dcorbeil/mysterium/mysterium_BOM.xlsx

Qty | Line Item | Manufacturer | MPN | Octopart URL | Schematic Reference | Internal Part Number | Description | Total Qty (@ Batch Size: 1) | SKU | Packaging | Unit Price (@ Batch Size: 1) | In Stock | MOQ | URL | Distributor [Lowest Price (Overall)] | SKU [Lowest Price (Overall)] | Packaging [Lowest Price (Overall)] | Unit Price (@ Batch Size: 1) [Lowest Price (Overall)] | Line Total [Lowest Price (Overall)] | Batch Total [Lowest Price (Overall)] | In Stock [Lowest Price (Overall)] | MOQ [Lowest Price (Overall)] | URL [Lowest Price (Overall)] | Notes
 |  |  |  |  |  |  |  |  | Mouser | Mouser | Mouser | Mouser | Mouser | Mouser
1 | ATMEGA32A-PU | Microchip | ATMEGA32A-PU | https://octopart.com/atmega32a-pu-microchip-77760288 |  |  | atmega32a-pu | 1 | 556-ATMEGA32A-PU | Tube | 3.88 | 215 | 1 | https://octopart.com/click/track?ai=8237&sig=0e0eec9&sid=2401&ppid=77760288&vpid=408978644&ct=offers | iodParts | ATMEGA32A-PU |  | 2.212 | 2.212 | 2.212 | 20 | 1 | https://octopart.com/click/track?ai=8237&sig=0d57c2a&sid=26822&ppid=77760288&vpid=418564695&ct=offers
1 | 1-2199299-5 | TE Connectivity | 1-2199299-5 | https://octopart.com/1-2199299-5-te+connectivity-34963610 |  |  | 40 pin ic socket | 1 | 571-1-2199299-5 | Tube | 0.79 | 10319 | 1 | https://octopart.com/click/track?ai=8237&sig=0bd913c&sid=2401&ppid=34963610&vpid=165549125&ct=offers | Future Electronics | 5048916 | Tube | 0.495 | 0.495 | 0.495 | 679 | 1 | https://octopart.com/click/track?ai=8237&sig=06217de&sid=2454&ppid=34963610&vpid=416925582&ct=offers
87 | 512-1N4148TR | ON Semiconductor | 1N4148TR | https://octopart.com/1n4148tr-on+semiconductor-84323125 |  |  | 1n4148 diode | 87 | 512-1N4148TR | Tape & Reel | 0.055 | 894714 | 1 | https://octopart.com/click/track?ai=8237&sig=010fed8&sid=2401&ppid=84323125&vpid=438579221&ct=offers | Freelance Electronics | 1N4148TR |  | 0.0045 | 0.3915 | 0.3915 | 15364 | 1 | https://octopart.com/click/track?ai=8237&sig=02951a1&sid=13062&ppid=84323125&vpid=44157962&ct=offers
2 | TZX3V6A-TR | Vishay | TZX3V6A-TR | https://octopart.com/tzx3v6a-tr-vishay-41954837 |  |  | zener diode (3.6v) | 2 | 78-TZX3V6A | Tape & Reel | 0.19 | 27260 | 1 | https://octopart.com/click/track?ai=8237&sig=07bdbc1&sid=2401&ppid=41954837&vpid=165620622&ct=offers | Arrow Electronics | TZX3V6A-TR | Cut Tape | 0.0741 | 0.1482 | 0.1482 | 28796 | 1 | https://octopart.com/click/track?ai=8237&sig=03dec76&sid=1106&ppid=41954837&vpid=473542905&ct=offers
1 | MF-R050 | Bourns | MF-R050 | https://octopart.com/mf-r050-bourns-19418 |  |  | 500mA fuse | 1 | 652-MFR050 | Bulk | 0.37 | 7313 | 1 | https://octopart.com/click/track?ai=8237&sig=00f51fc&sid=2401&ppid=19418&vpid=37642983&ct=offers | Newark | 58K1838 |  | 0.293 | 0.293 | 0.293 | 4792 | 1 | https://octopart.com/click/track?ai=8237&sig=0504032&sid=2402&ppid=19418&vpid=2999775&ct=offers
2 | 603-CFR-12JR-52-75R | Yageo | CFR-12JR-52-75R | https://octopart.com/cfr-12jr-52-75r-yageo-22569004 |  |  | 75 ohm resistor (1/6w) | 2 | 603-CFR-12JR-52-75R | Tape & Reel | 0.1 | 2943 | 1 | https://octopart.com/click/track?ai=8237&sig=0306453&sid=2401&ppid=22569004&vpid=459007506&ct=offers | Mouser | 603-CFR-12JR-52-75R | Tape & Reel | 0.1 | 0.2 | 0.2 | 2943 | 1 | https://octopart.com/click/track?ai=8237&sig=0306453&sid=2401&ppid=22569004&vpid=459007506&ct=offers
2 | MFR-12FTF52-1K5 | Yageo | MFR-12FTF52-1K5 | https://octopart.com/mfr-12ftf52-1k5-yageo-70521551 |  |  | 1.5k resistor (1/6w) | 2 | 603-MFR-12FTF52-1K5 | Ammo Pack | 0.14 | 7317 | 1 | https://octopart.com/click/track?ai=8237&sig=05e16d3&sid=2401&ppid=70521551&vpid=248138223&ct=offers | Mouser | 603-MFR-12FTF52-1K5 | Ammo Pack | 0.14 | 0.28 | 0.28 | 7317 | 1 | https://octopart.com/click/track?ai=8237&sig=05e16d3&sid=2401&ppid=70521551&vpid=248138223&ct=offers
2 | MFR-12FTF52-5K1 | Yageo | MFR-12FTF52-5K1 | https://octopart.com/mfr-12ftf52-5k1-yageo-27599083 |  |  | 5.1k resistor (1/6w) | 2 | 603-MFR-12FTF52-5K1 | Ammo Pack | 0.14 | 2811 | 1 | https://octopart.com/click/track?ai=8237&sig=035d3f5&sid=2401&ppid=27599083&vpid=69905114&ct=offers | Mouser | 603-MFR-12FTF52-5K1 | Ammo Pack | 0.14 | 0.28 | 0.28 | 2811 | 1 | https://octopart.com/click/track?ai=8237&sig=035d3f5&sid=2401&ppid=27599083&vpid=69905114&ct=offers
1 | MFR-12FTF52-10K | Yageo | MFR-12FTF52-10K | https://octopart.com/mfr-12ftf52-10k-yageo-27599081 |  |  | 10k resistor (1/6w) | 1 | 603-MFR-12FTF52-10K | Ammo Pack | 0.14 | 0 | 1 | https://octopart.com/click/track?c=1&ai=8237&sig=06c5f3c&sid=2401&ppid=27599081&vpid=69905112&ct=offers | Arrow.cn | MFR12FTF5210K#YAGEO |  | 0.0594 | 0.0594 | 0.0594 | 2360 | 1 | https://octopart.com/click/track?ai=8237&sig=0be1695&sid=28928&ppid=27599081&vpid=617478633&ct=offers
1 | UMT1H4R7MDD | Nichicon | UMT1H4R7MDD | https://octopart.com/umt1h4r7mdd-nichicon-19784074 |  |  | 4.7uF capacitor | 1 | 647-UMT1H4R7MDD | Bulk | 0.21 | 0 | 1 | https://octopart.com/click/track?c=1&ai=8237&sig=044daa9&sid=2401&ppid=19784074&vpid=456325084&ct=offers | Mouser | 647-UMT1H4R7MDD | Bulk | 0.21 | 0.21 | 0.21 | 0 | 1 | https://octopart.com/click/track?c=1&ai=8237&sig=044daa9&sid=2401&ppid=19784074&vpid=456325084&ct=offers
2 | RDER71H104K0M1H03A | Murata | RDER71H104K0M1H03A | https://octopart.com/rder71h104k0m1h03a-murata-38816908 |  |  | 0.1uF capacitor | 2 | 81-RDER71H104K0M1H3A | Ammo Pack | 0.31 | 58783 | 1 | https://octopart.com/click/track?ai=8237&sig=0178a58&sid=2401&ppid=38816908&vpid=193794682&ct=offers | Arrow Electronics | RDER71H104K0M1H03A | Cut Tape | 0.2832 | 0.5664 | 0.5664 | 51 | 1 | https://octopart.com/click/track?ai=8237&sig=051aa36&sid=1106&ppid=38816908&vpid=473338386&ct=offers
2 | RCE5C2A220J0A2H03B | Murata | RCE5C2A220J0A2H03B | https://octopart.com/rce5c2a220j0a2h03b-murata-30233632 |  |  | 22pF capacitor | 2 | 81-RCE5C2A220J0A2H3B | Bulk | 0.48 | 2392 | 1 | https://octopart.com/click/track?ai=8237&sig=0b9f246&sid=2401&ppid=30233632&vpid=89300106&ct=offers | Mouser | 81-RCE5C2A220J0A2H3B | Bulk | 0.48 | 0.96 | 0.96 | 2392 | 1 | https://octopart.com/click/track?ai=8237&sig=0b9f246&sid=2401&ppid=30233632&vpid=89300106&ct=offers
1 | ABL-16.000MHz-B4Y | Abracon | ABL-16.000MHZ-B4Y | https://octopart.com/abl-16.000mhz-b4y-abracon-75296064 |  |  | 16mhz crystal | 1 | 815-ABL-16-B4Y | Bulk | 0.34 | 718 | 1 | https://octopart.com/click/track?ai=8237&sig=02adf4a&sid=2401&ppid=75296064&vpid=269061007&ct=offers | Mouser | 815-ABL-16-B4Y | Bulk | 0.34 | 0.34 | 0.34 | 718 | 1 | https://octopart.com/click/track?ai=8237&sig=02adf4a&sid=2401&ppid=75296064&vpid=269061007&ct=offers
2 | MJTP1230A | APEM | MJTP1230A | https://octopart.com/mjtp1230a-apem-912864 |  |  | 6mm pushbutton | 2 | 642-MJTP1230A | Bulk | 0.2 | 4431 | 1 | https://octopart.com/click/track?ai=8237&sig=0b34d1b&sid=2401&ppid=912864&vpid=37704731&ct=offers | Heilind Electronics | MJTP1230A |  | 0.1336 | 0.2672 | 0.2672 | 421 | 1 | https://octopart.com/click/track?ai=8237&sig=0cae029&sid=8539&ppid=912864&vpid=681009617&ct=offers
1 | LTL-4222 | Lite-On | LTL-4222 | https://octopart.com/ltl-4222-lite-on-869424 |  |  | 3mm led | 1 | 859-LTL-4222 | Bulk | 0.12 | 7121 | 1 | https://octopart.com/click/track?ai=8237&sig=0c1aafa&sid=2401&ppid=869424&vpid=37629764&ct=offers | Mouser | 859-LTL-4222 | Bulk | 0.12 | 0.12 | 0.12 | 7121 | 1 | https://octopart.com/click/track?ai=8237&sig=0c1aafa&sid=2401&ppid=869424&vpid=37629764&ct=offers
1 | 68602-406HLF | Amphenol ICC / FCI | 68602-406HLF | https://octopart.com/68602-406hlf-amphenol+icc+%2F+fci-90340423 |  |  | 2x3 pin header | 1 | 649-68602-406HLF | Bulk | 0.26 | 2481 | 1 | https://octopart.com/click/track?ai=8237&sig=025a293&sid=2401&ppid=90340423&vpid=114998247&ct=offers | Future Electronics | 1100831 | Bag | 0.115 | 0.115 | 0.115 | 0 | 1 | https://octopart.com/click/track?c=1&ai=8237&sig=00c743f&sid=2454&ppid=90340423&vpid=482070349&ct=offers
1 | USB4085-GF-A | GCT | USB4085-GF-A | https://octopart.com/usb4085-gf-a-gct-99340357 |  |  | through hole 16-pin usb type-c jack | 1 | 640-USB4085-GF-A | Bulk | 1.34 |  |  |  | Mouser | 2073-USB4085-GF-ACT-ND | Cut Tape | 1.34 | 1.34 | 1.34 | 4617 | 1 | https://octopart.com/click/track?c=1&ai=8237&sig=0159c35&sid=459&ppid=99340357&vpid=531364782&ct=offers
1 | MFR-12FRF52-10K | Yageo | MFR-12FRF52-10K |  |  |  | 10k resistor (1/6w) | 1 | 603-MFR-12FRF5210K | Ammo Pack | 0.1
1 | USR1H4R7MDD1TP | Nichicon | USR1H4R7MDD1TP |  |  |  | 4.7uF capacitor | 1 | 647-USR1H4R7MDD1TP | Cut Tape | 0.2
