dcorbeil/mysterium/case/minimal/mysterium-foot-1.dxf

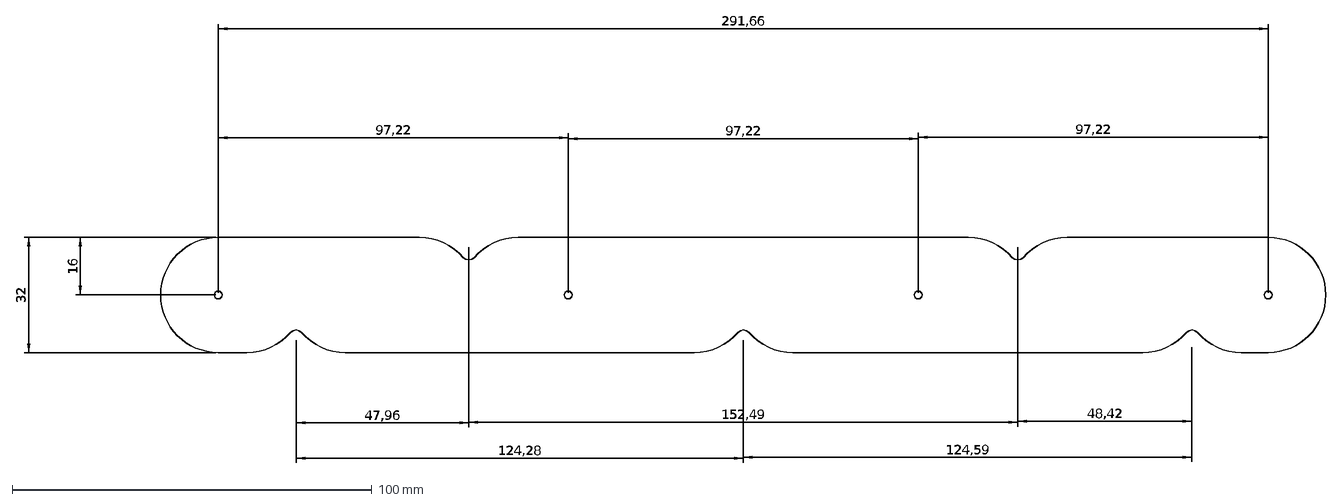
[picture p1: CAD file, 2021-04-19]
case/minimal/mysterium-foot-1.dxf
16
32
291,66
97,22
47,96
152,49
48,42
124,28
124,59
