dcorbeil/mysterium/case/standard/mysterium-foot-1.dxf

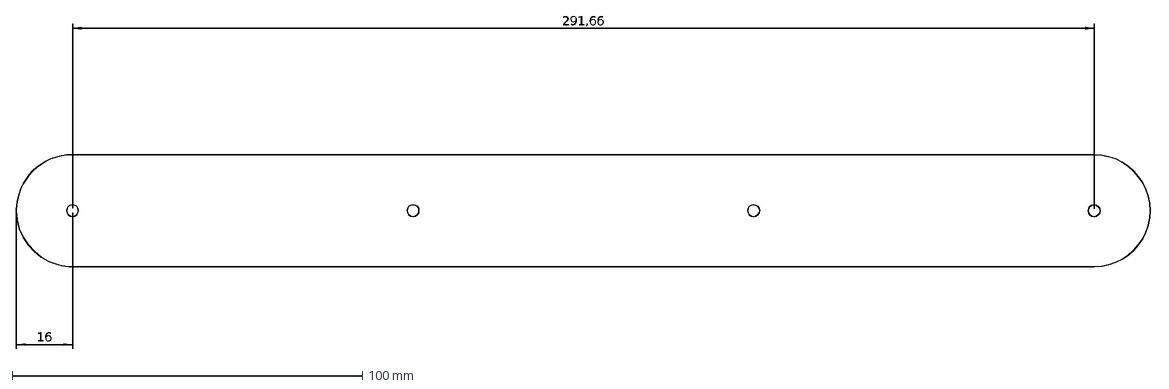
[picture p2: CAD file, 2021-02-24]
case/standard/mysterium-foot-1.dxf
291,66
16
