dcorbeil/mysterium/case/minimal/mysterium-bottom.dxf

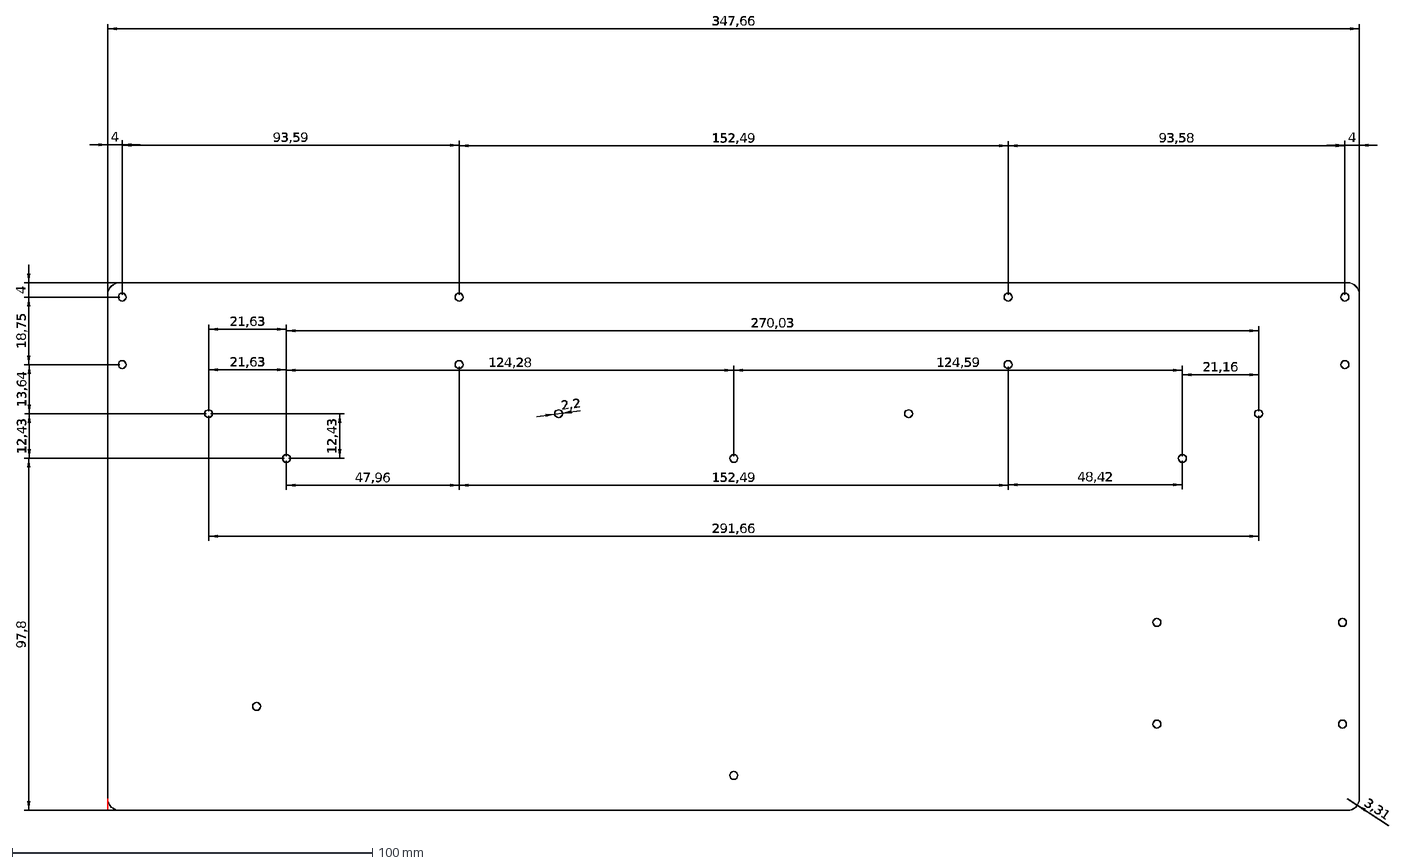
[picture p3: CAD file, 2021-04-19]
case/minimal/mysterium-bottom.dxf
347,66
97,8
3,31
152,49
93,59
4
93,58
13,64
12,43
18,75
2,2
21,16
21,63
270,03
291,66
124,28
124,59
47,96
48,42
