dcorbeil/mysterium/case/minimal/mysterium-nav-acrylic.dxf

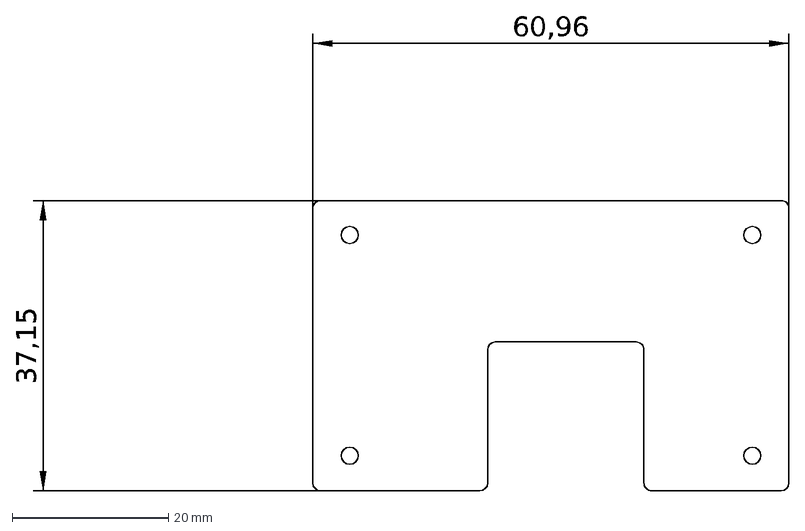
[picture p4: CAD file, 2021-04-19]
case/minimal/mysterium-nav-acrylic.dxf
60,96
37,15
