dcorbeil/mysterium/case/minimal/mysterium-foot-4.dxf

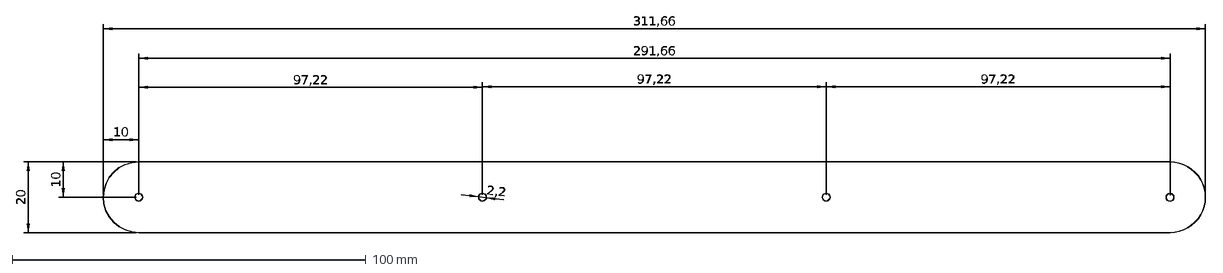
[picture p5: CAD file, 2021-04-05]
case/minimal/mysterium-foot-4.dxf
97,22
10
311,66
20
291,66
2,2
