dcorbeil/mysterium/case/minimal/mysterium-foot-2.dxf

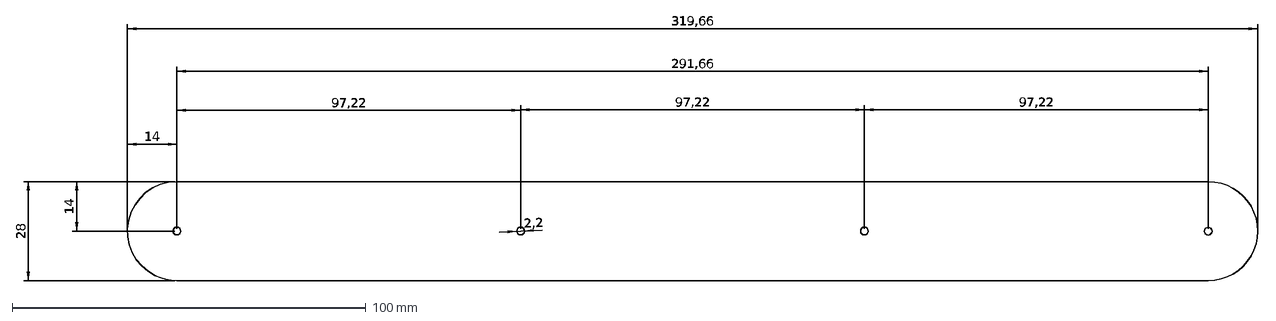
[picture p6: CAD file, 2021-04-05]
case/minimal/mysterium-foot-2.dxf
97,22
319,66
291,66
14
28
2,2
