dcorbeil/mysterium/case/minimal/mysterium-acrylic-guard.dxf

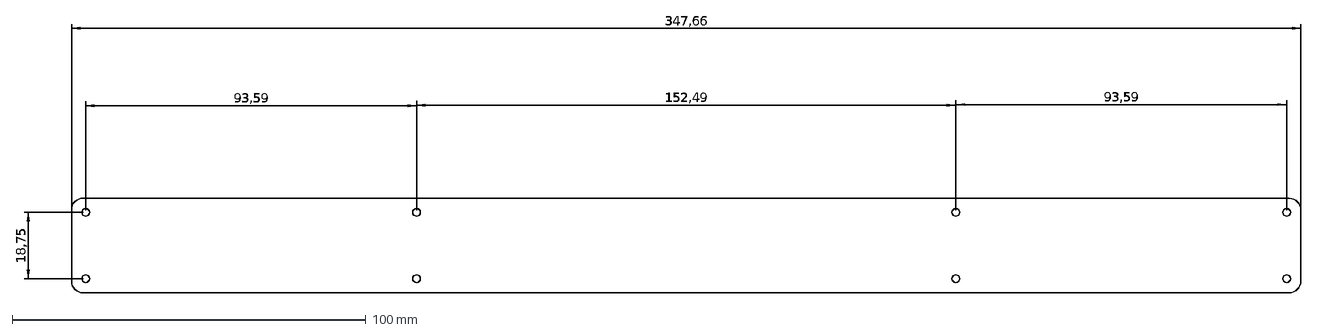
[picture p7: CAD file, 2021-04-03]
case/minimal/mysterium-acrylic-guard.dxf
18,75
93,59
152,49
347,66
