dcorbeil/mysterium/case/minimal/mysterium-foot-3.dxf

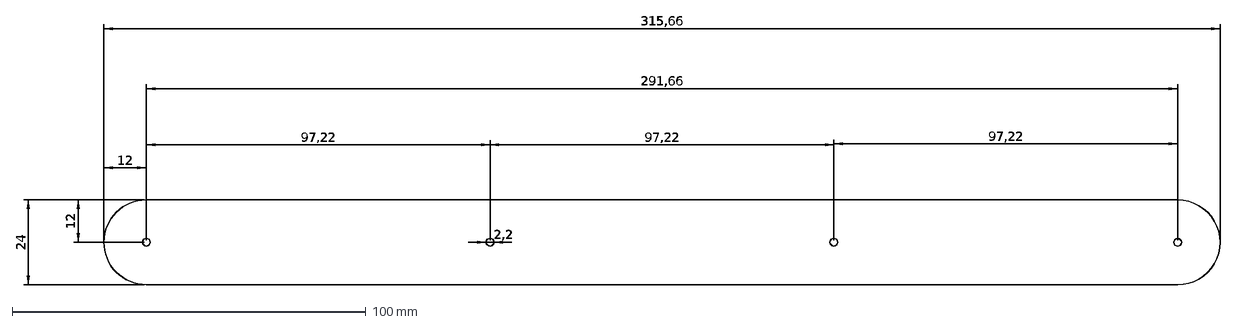
[picture p8: CAD file, 2021-02-24]
case/minimal/mysterium-foot-3.dxf
97,22
291,66
315,66
12
24
2,2
