dcorbeil/mysterium/case/minimal/nav-acrylic.dxf

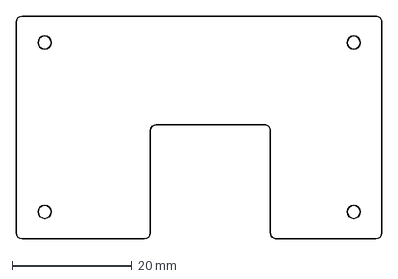
[picture p9: CAD file, 2021-02-23]
case/minimal/nav-acrylic.dxf
61.0 x 37.2 mm
