dcorbeil/mysterium/case/minimal/mysterium-kit-plate.dxf

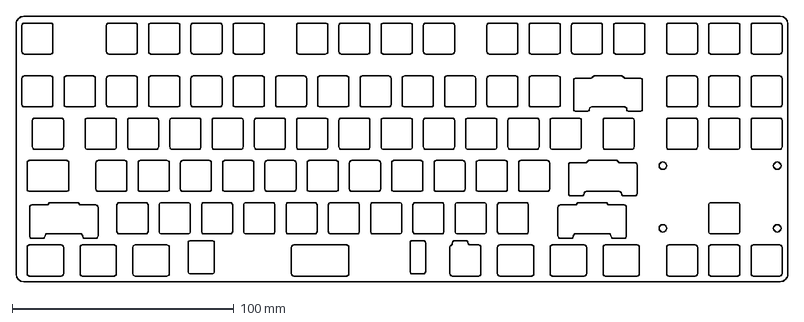
[picture p10: CAD file, 2021-02-23]
case/minimal/mysterium-kit-plate.dxf
347.7 x 119.5 mm
