dcorbeil/mysterium/(commit log)

2021-02-23 Added foot and bottom
    [mysterium-bottom.dxf, mysterium-foot-1.dxf, mysterium-foot-2.dxf, mysterium-foot-3.dxf, mysterium-foot-4.dxf]
2021-02-23 Moved root level dxf to it a dedicated folder
    [mysterium-acrylic-guard.dxf, mysterium-kit-plate.dxf, mysterium-nav-acrylic.dxf, nav-acrylic.dxf]
2021-02-24 Started forming feet for bottom hole pattern
    [mysterium-bottom.dxf, mysterium-foot-1.dxf, mysterium-foot-2.dxf, mysterium-foot-3.dxf]
2021-02-24 fixed feet and bottom to keep the 291.66mm distance between the feet's outer holes
    [mysterium-bottom.dxf, mysterium-foot-1.dxf, mysterium-foot-2.dxf, mysterium-foot-3.dxf, mysterium-foot-4.dxf]
2021-03-02 added 3rd row of holes
    [mysterium-bottom.dxf]
2021-04-03 added the right type of foot (foot-2) and added dimensions to bottom
    [mysterium-bottom.dxf, mysterium-foot-1.dxf, mysterium-foot-2.dxf]
2021-04-03 added dimensions
    [mysterium-foot-1.dxf, mysterium-foot-2.dxf, mysterium-foot-4.dxf]
2021-04-05 Added room for case bottom screws
    [mysterium-foot-1.dxf, mysterium-foot-2.dxf]
2021-04-05 really added room for case bottom screws
    [mysterium-foot-1.dxf]
2021-04-05 reverted foot 2 to no room for case bottom
    [mysterium-foot-2.dxf, mysterium-foot-4.dxf]
2021-04-05 (final) minimal case version
    [mysterium-bottom.dxf, mysterium-foot-1.dxf, mysterium-foot-4.dxf]
2021-04-19 added electrical components BOM
    [mysterium_BOM.xlsx]
2021-04-19 fixed foot-1 because the dents were to tight with the bottom
    [mysterium-bottom.dxf, mysterium-foot-1.dxf, mysterium-nav-acrylic.dxf]
